bikerglen/pixpoe/README.md

# pixpoe
Control and power up to 20 W of neopixels or other WS2812b LEDs over ethernet!
