bikerglen/pixpoe/prints/2019-11-24/PixPoE-bottom-as-fabbed-2019-11-24.png

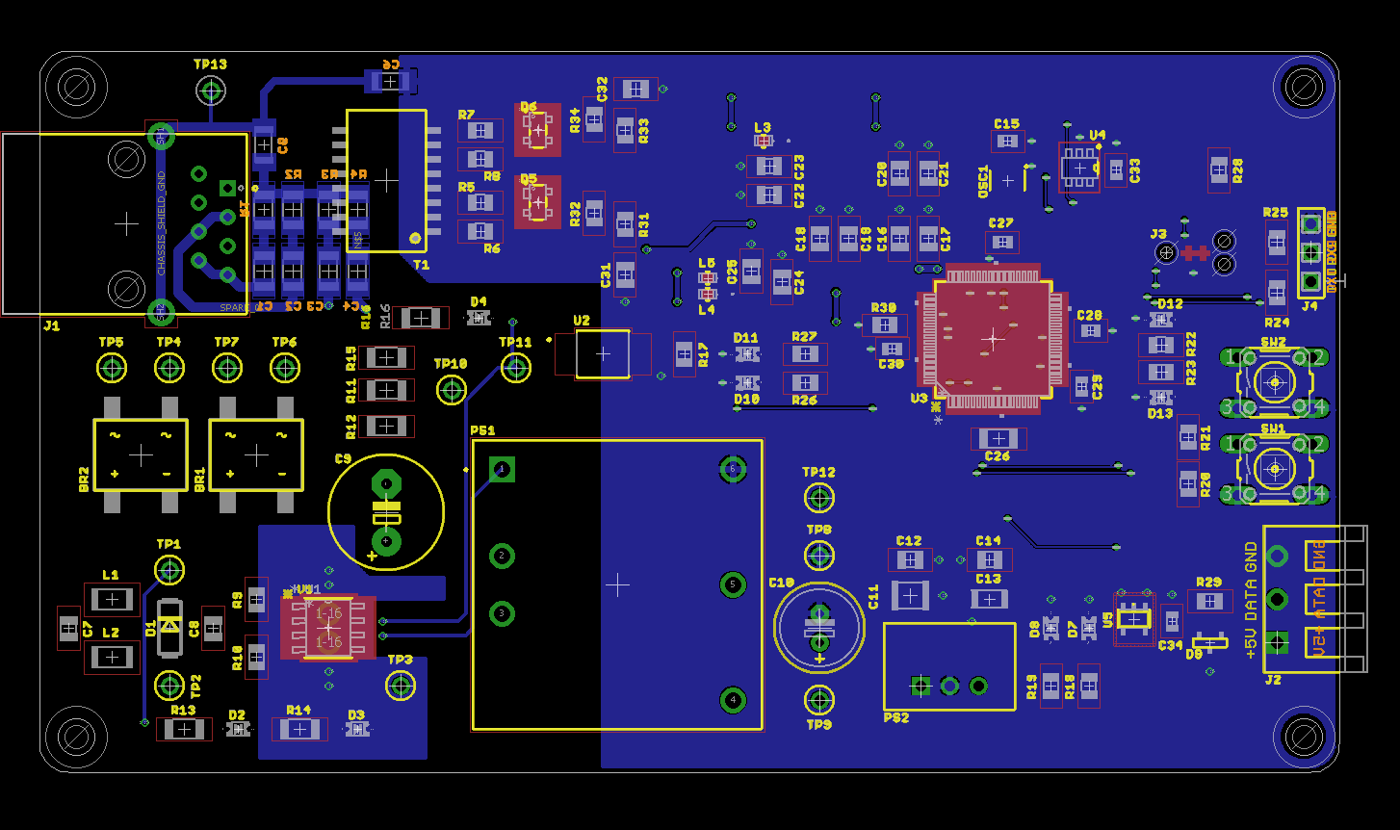
prints/2019-11-24/PixPoE-bottom-as-fabbed-2019-11-24.png
