bikerglen/pixpoe/(threads)

Thread 1 (2020-01-02):

BOM?

jayjlow, 2020-01-02:
Sorry if I missed it in your blog, but is there a handy BOM available?

bikerglen, 2020-01-02:
I'll upload it tonight after work. It's in the form of an Excel spreadsheet with Manufacturer and Digi-Key part numbers.

jayjlow, 2020-01-02:
Awe yeah. Thanks for responding so quickly. Have a great new years.

bikerglen, 2020-01-03:
BOM added to boards/v2 directory.

Closed 2020-01-02.
