bikerglen/pixpoe/prints/2019-11-24/PixPoE-schematic-as-fabbed-2019-11-24.pdf

# 7 R5

R18 | D7 R19 | D8 C6

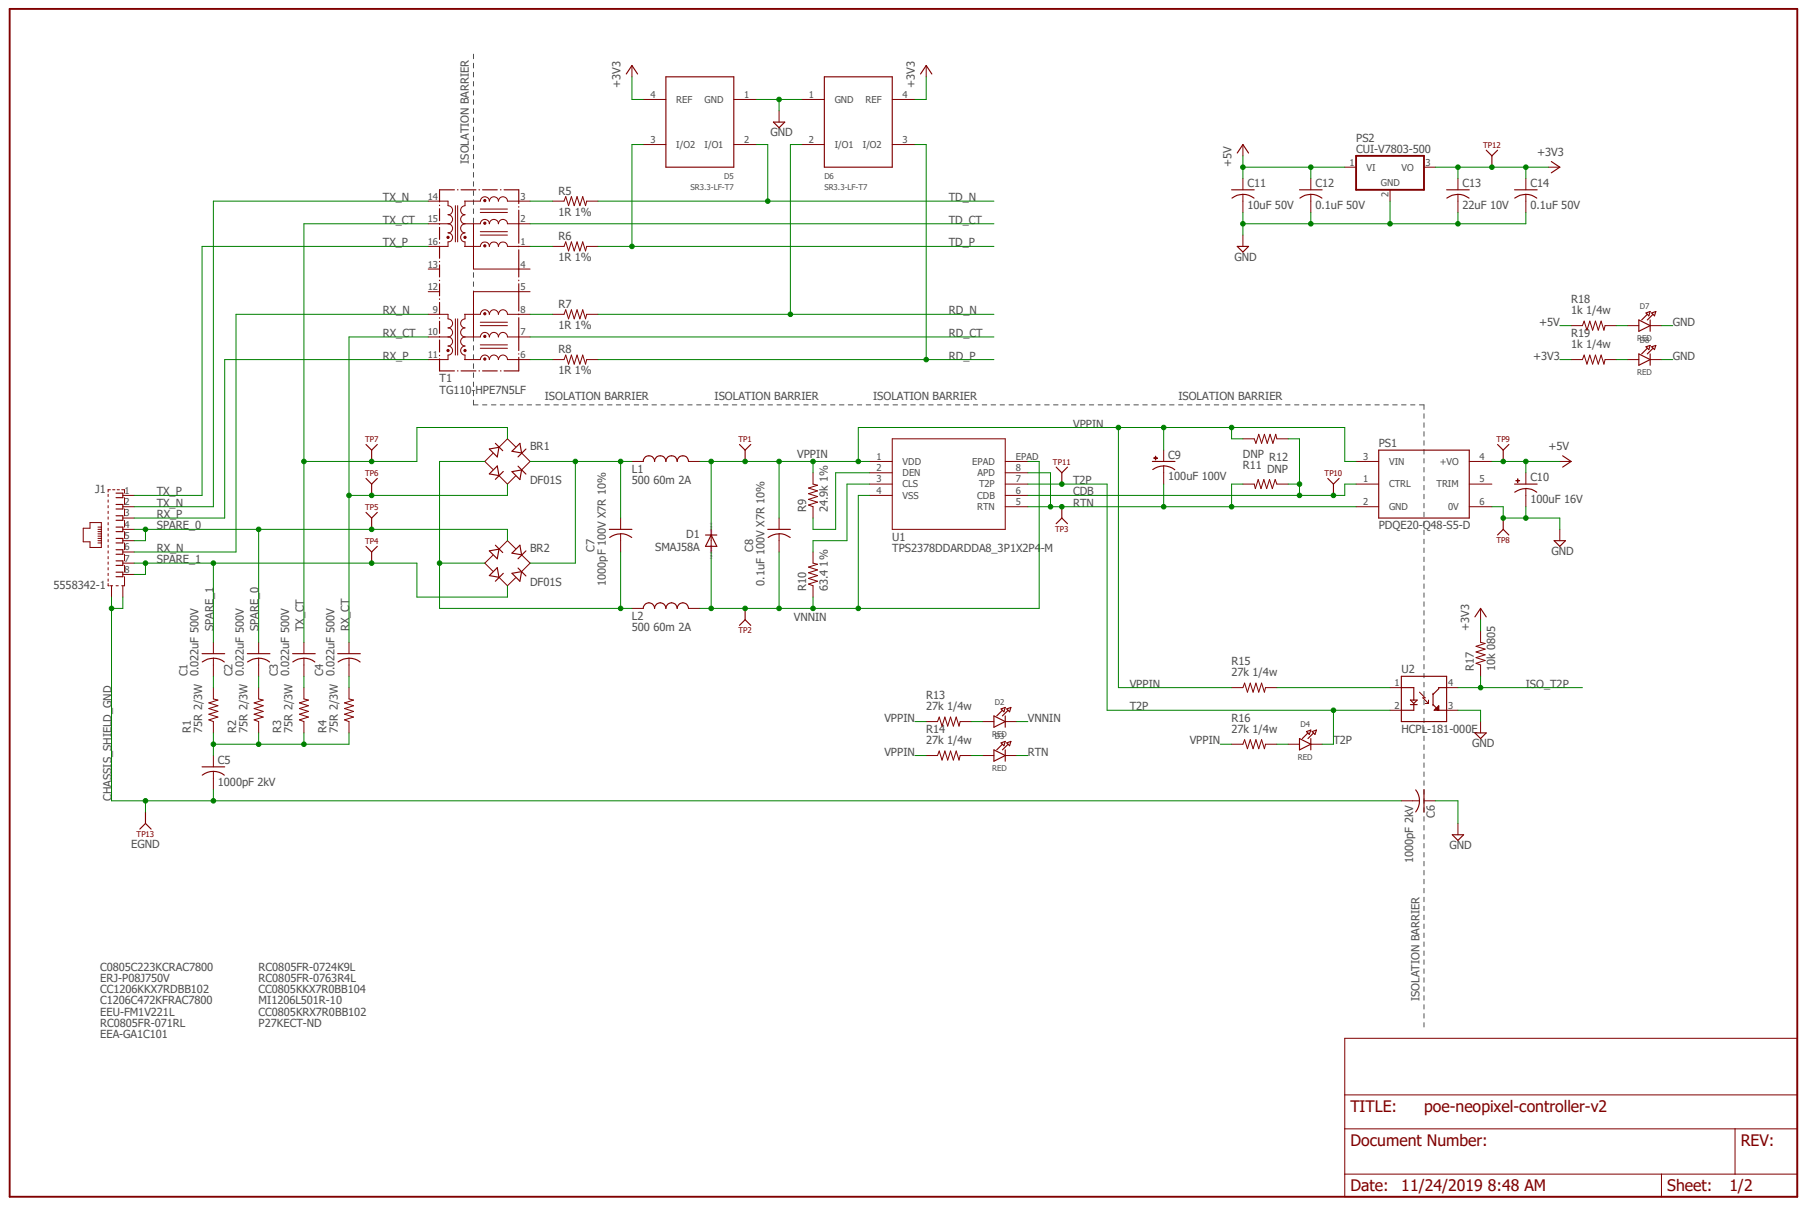
[picture p4: page 1]

Document Number: | REV:

Date: 11/24/2019 8:48 AM | Sheet: 1/2

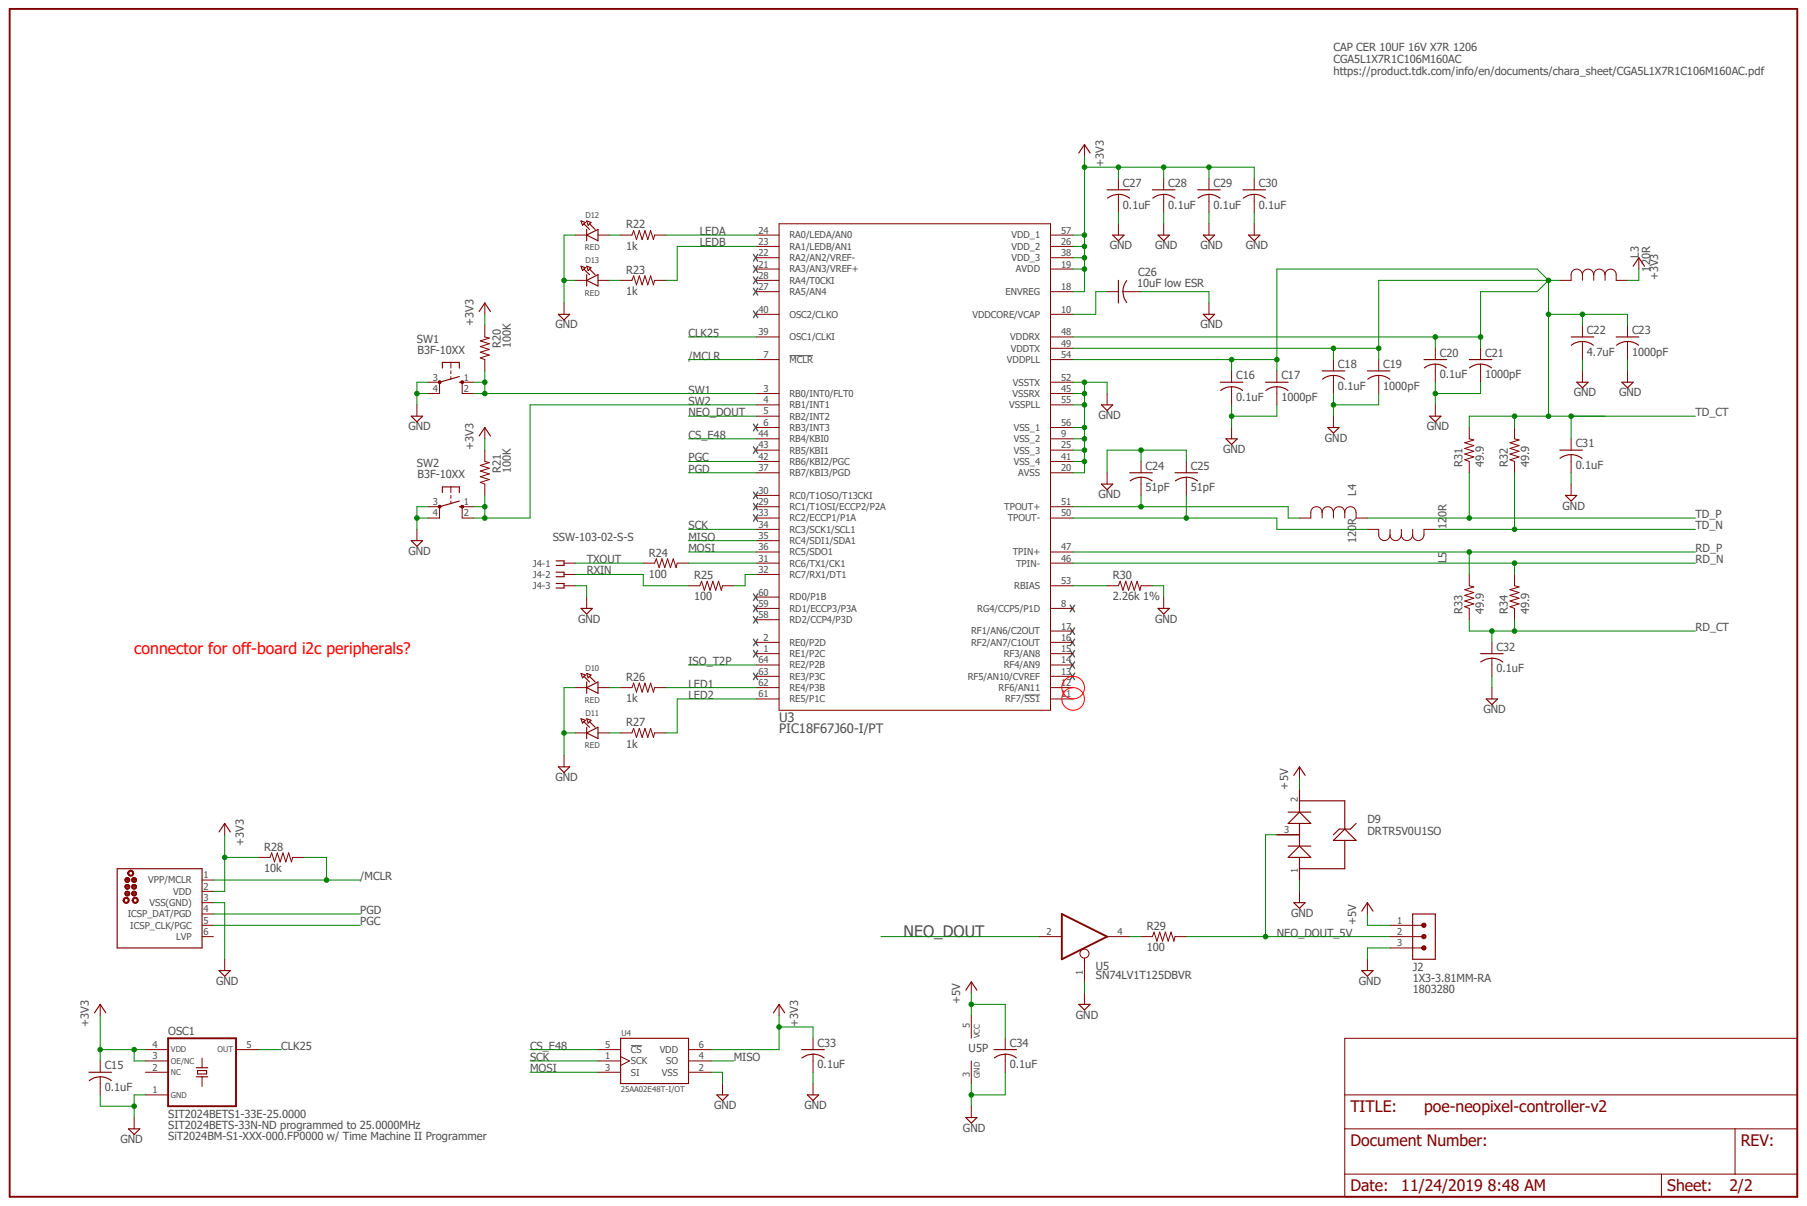
[picture p5: page 2]

CAP CER 10UF 16V X7R 1206
CGA5L1X7R1C106M160AC
https://product.tdk.com/info/en/documents/chara_sheet/CGA5L1X7R1C106M160AC.pdf

connector for off-board i2c peripherals?

SIT2024BETS1-33E-25.0000
SIT2024BETS-33N-ND programmed to 25.0000MHz
SiT2024BM-S1-XXX-000.FP0000 w/ Time Machine II Programmer

Document Number: | REV:

Date: 11/24/2019 8:48 AM | Sheet: 2/2
