bikerglen/pixpoe/boards/v2/poe-neopixel-controller-v2.brd

## EAGLE design boards/v2/poe-neopixel-controller-v2.brd (2019-11-24)

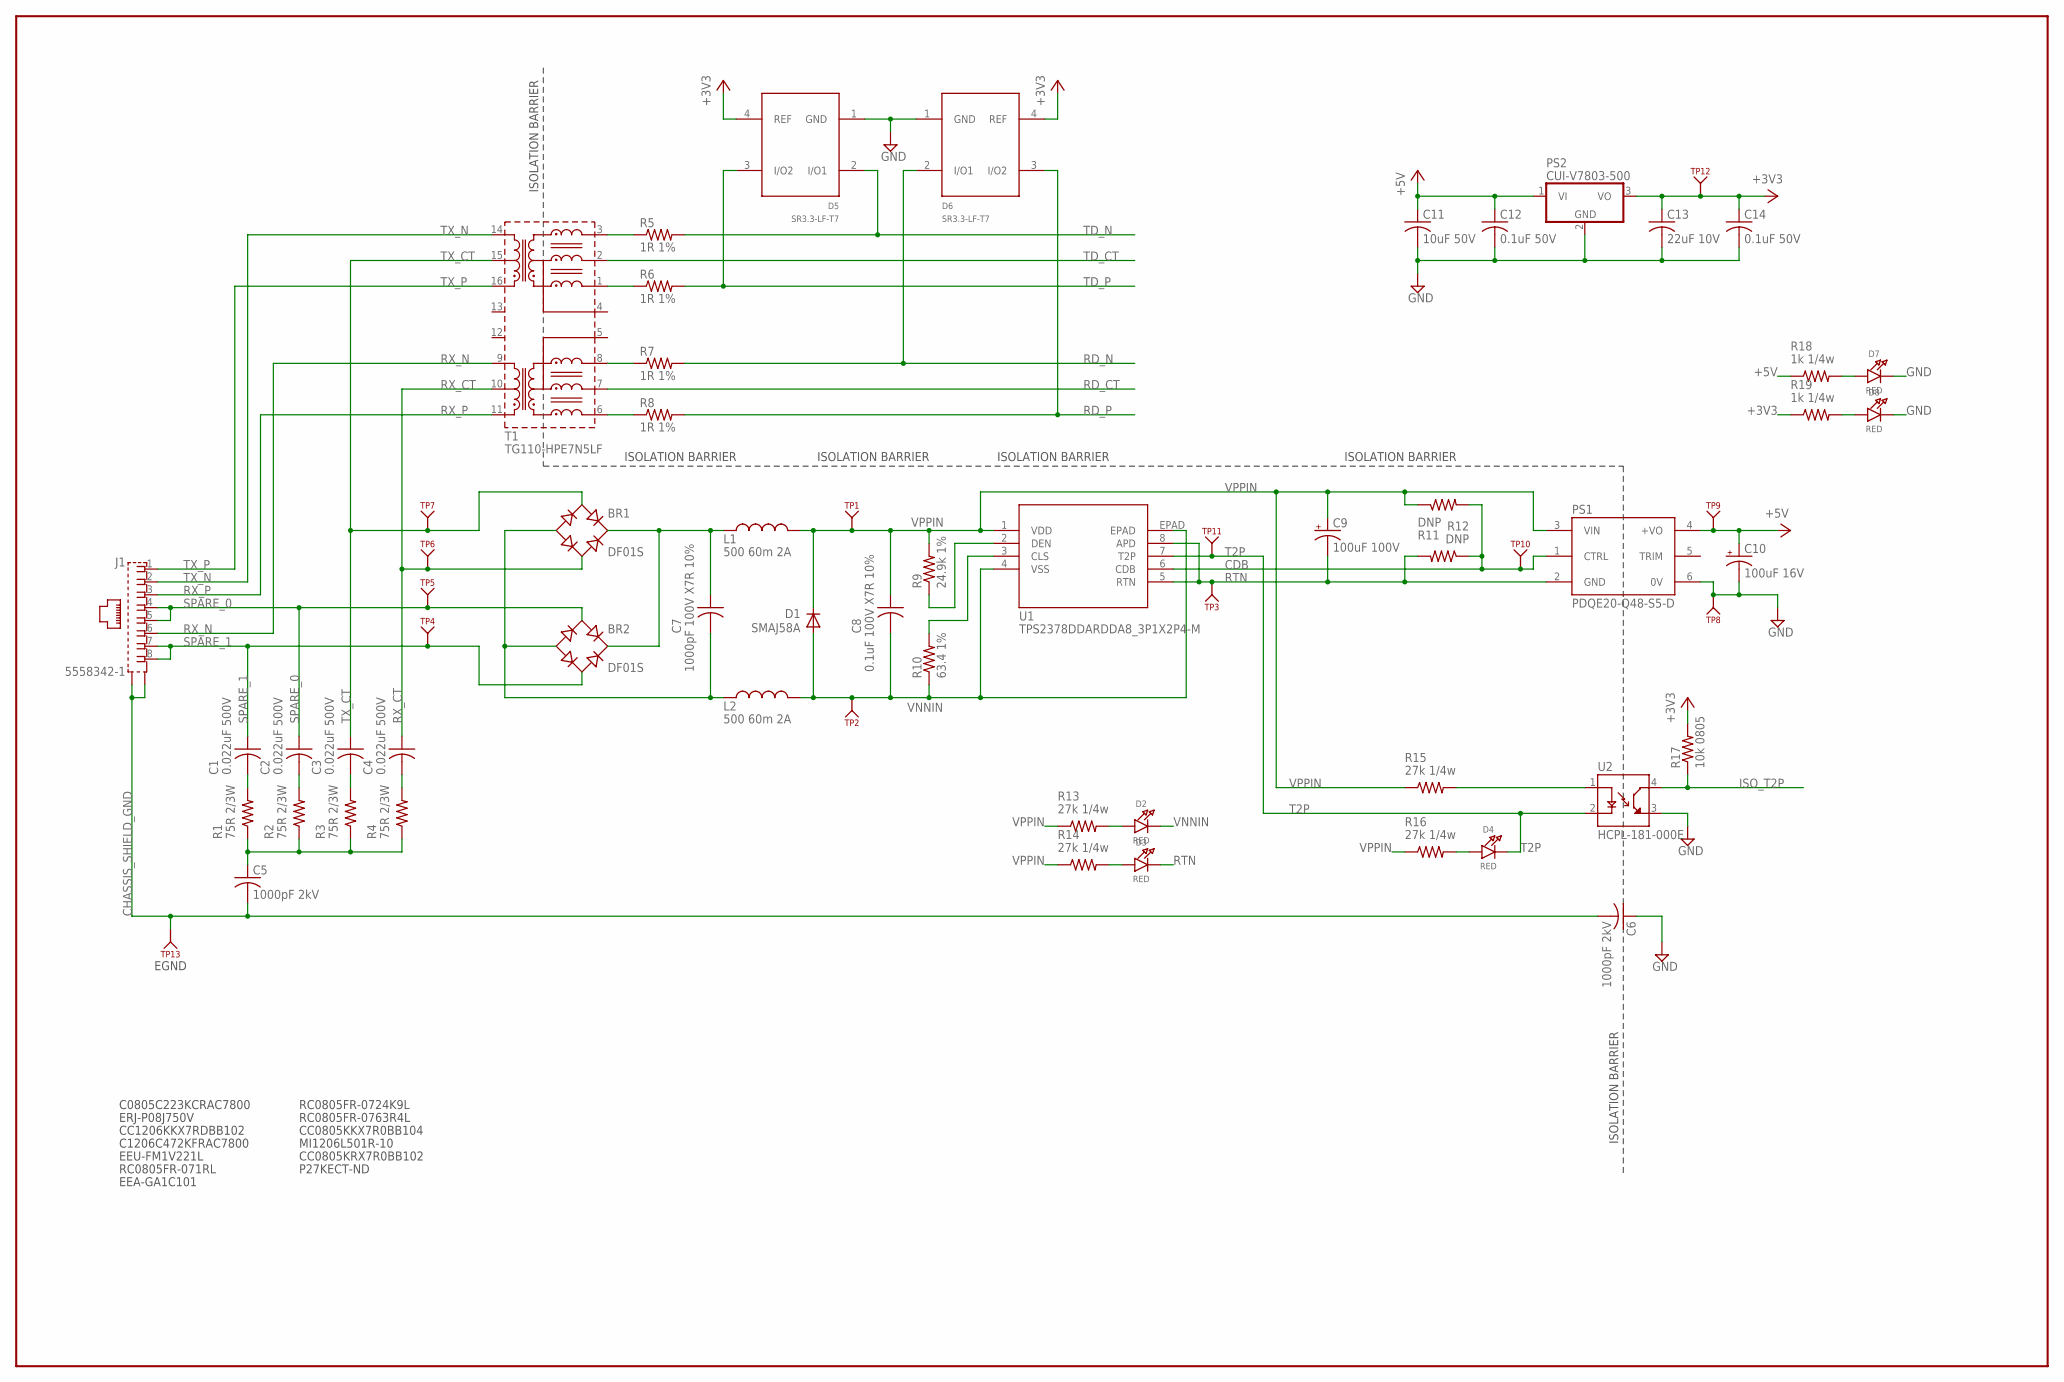
[picture p6: schematic poe-neopixel-controller-v2.sch, sheet 1]

Parts:
BR1, BR2: DF01S; DFS
C1, C2, C3, C4: 0.022uF 500V; C1206
C5, C6: 1000pF 2kV; C1206K
C7: 1000pF 100V X7R 10%; C0805
C8: 0.1uF 100V X7R 10%; C0805
C9: 100uF 100V; E5-10,5
C10: 100uF 16V; E2,5-7
C11: 10uF 50V; C1210K; MFR_PART_NO C1210C106K5RACTU
C12, C14: 0.1uF 50V; C0805; MFR_PART_NO C1206S104M5RACTU
C13: 22uF 10V; C1206K; MFR_PART_NO C1206C226K8RAC7800
D1: SMAJ58A; DO214AC
D2, D3, D4, D7, D8: RED; CHIPLED_0805_NOOUTLINE
D5, D6: SR3.3-LF-T7; SOT143B
J1: 5558342-1; TE_5558342-1
L1, L2: 500 60m 2A; L3216C
PS1: PDQE20-Q48-S5-D; CONV_PDQE20-Q48-S5-D
PS2: CUI-V7803-500; CUI-78XX-500
R1, R2, R3, R4: 75R 2/3W; R1206
R5, R6, R7, R8: 1R 1%; R0805
R9: 24.9k 1%; R0805
R10: 63.4 1%; R0805
R11, R12: DNP; R1206
R13, R14, R15, R16: 27k 1/4w; R1206
R17: 10k 0805; R0805
R18, R19: 1k 1/4w; R0805
T1: TG110-HPE7N5LF; RP-ULTRA
TP1, TP2, TP3, TP4, TP5, TP6, TP7, TP8, TP9, TP10, TP11, TP12, TP13: KEYSTONE_500X; KEYSTONE_TP500X
U1: TPS2378DDARDDA8_3P1X2P4-M; DDA8_3P1X2P4-M
U2: HCPL-181-000E; SOIC254P675X240-4N

Connections:
+3V3: C13.1, C14.1, D5.4 (REF), D6.4 (REF), PS2.3 (VO), R17.2, R19.1, TP12.1; also elsewhere on the board
+5V: C10.+, C11.1, C12.1, PS1.4 (+VO), PS2.1 (VI), R18.1, TP9.1; also elsewhere on the board
CDB: PS1.1 (CTRL), R11.2, R12.1, TP10.1, U1.6 (CDB)
CHASSIS_SHIELD_GND: C5.2, C6.2, J1.SH1 (S1), J1.SH2 (S2), TP13.1
GND: C6.1, C10.-, C11.2, C12.2, C13.2, C14.2, D5.1 (GND), D6.1 (GND), D7.C, D8.C, PS1.6 (0V), PS2.2 (GND), TP8.1, U2.3 (EMITTER); also elsewhere on the board
ISO_T2P: R17.1, U2.4 (COLLECTOR); also elsewhere on the board
unnamed: BR1.+, BR2.+, C7.1, L1.1
unnamed: R5.1, T1.3
unnamed: BR1.-, BR2.-, C7.2, L2.1
unnamed: R6.1, T1.1
unnamed: C4.2, R4.2
unnamed: R7.1, T1.8
unnamed: D2.A, R13.2
unnamed: R15.2, U2.1 (ANODE)
unnamed: R8.1, T1.6
unnamed: C1.2, R1.2
unnamed: C2.2, R2.2
unnamed: C3.2, R3.2
unnamed: C5.1, R1.1, R2.1, R3.1, R4.1
unnamed: R9.1, U1.2 (DEN)
unnamed: R10.2, U1.3 (CLS)
unnamed: D3.A, R14.2
unnamed: D4.A, R16.2
unnamed: D7.A, R18.2
unnamed: D8.A, R19.2
RD_CT: T1.7; also elsewhere on the board
RD_N: D6.2 (I/O1), R7.2; also elsewhere on the board
RD_P: D6.3 (I/O2), R8.2; also elsewhere on the board
RTN: C9.-, D3.C, PS1.2 (GND), R12.2, TP3.1, U1.5 (RTN), U1.8 (APD)
RX_CT: BR1.AC2, C4.1, T1.10, TP6.1
RX_N: J1.6, T1.9
RX_P: J1.3, T1.11
SPARE_0: BR2.AC1, C2.1, J1.4, J1.5, TP5.1
SPARE_1: BR2.AC2, C1.1, J1.7, J1.8, TP4.1
T2P: D4.C, TP11.1, U1.7 (T2P), U2.2 (CATHODE)
TD_CT: T1.2; also elsewhere on the board
TD_N: D5.2 (I/O1), R5.2; also elsewhere on the board
TD_P: D5.3 (I/O2), R6.2; also elsewhere on the board
TX_CT: BR1.AC1, C3.1, T1.15, TP7.1
TX_N: J1.2, T1.14
TX_P: J1.1, T1.16
VNNIN: C8.2, D1.A, D2.C, L2.2, R10.1, TP2.1, U1.4 (VSS), U1.EPAD
VPPIN: C8.1, C9.+, D1.C, L1.2, PS1.3 (VIN), R9.2, R11.1, R13.1, R14.1, R15.1, R16.1, TP1.1, U1.1 (VDD)

Notes on the sheet:
C0805C223KCRAC7800
ERJ-P08J750V
CC1206KKX7RDBB102
C1206C472KFRAC7800
EEU-FM1V221L
ISOLATION BARRIER
RC0805FR-071RL
EEA-GA1C101
RC0805FR-0724K9L
RC0805FR-0763R4L
CC0805KKX7R0BB104
MI1206L501R-10
CC0805KRX7R0BB102
P27KECT-ND
EGND

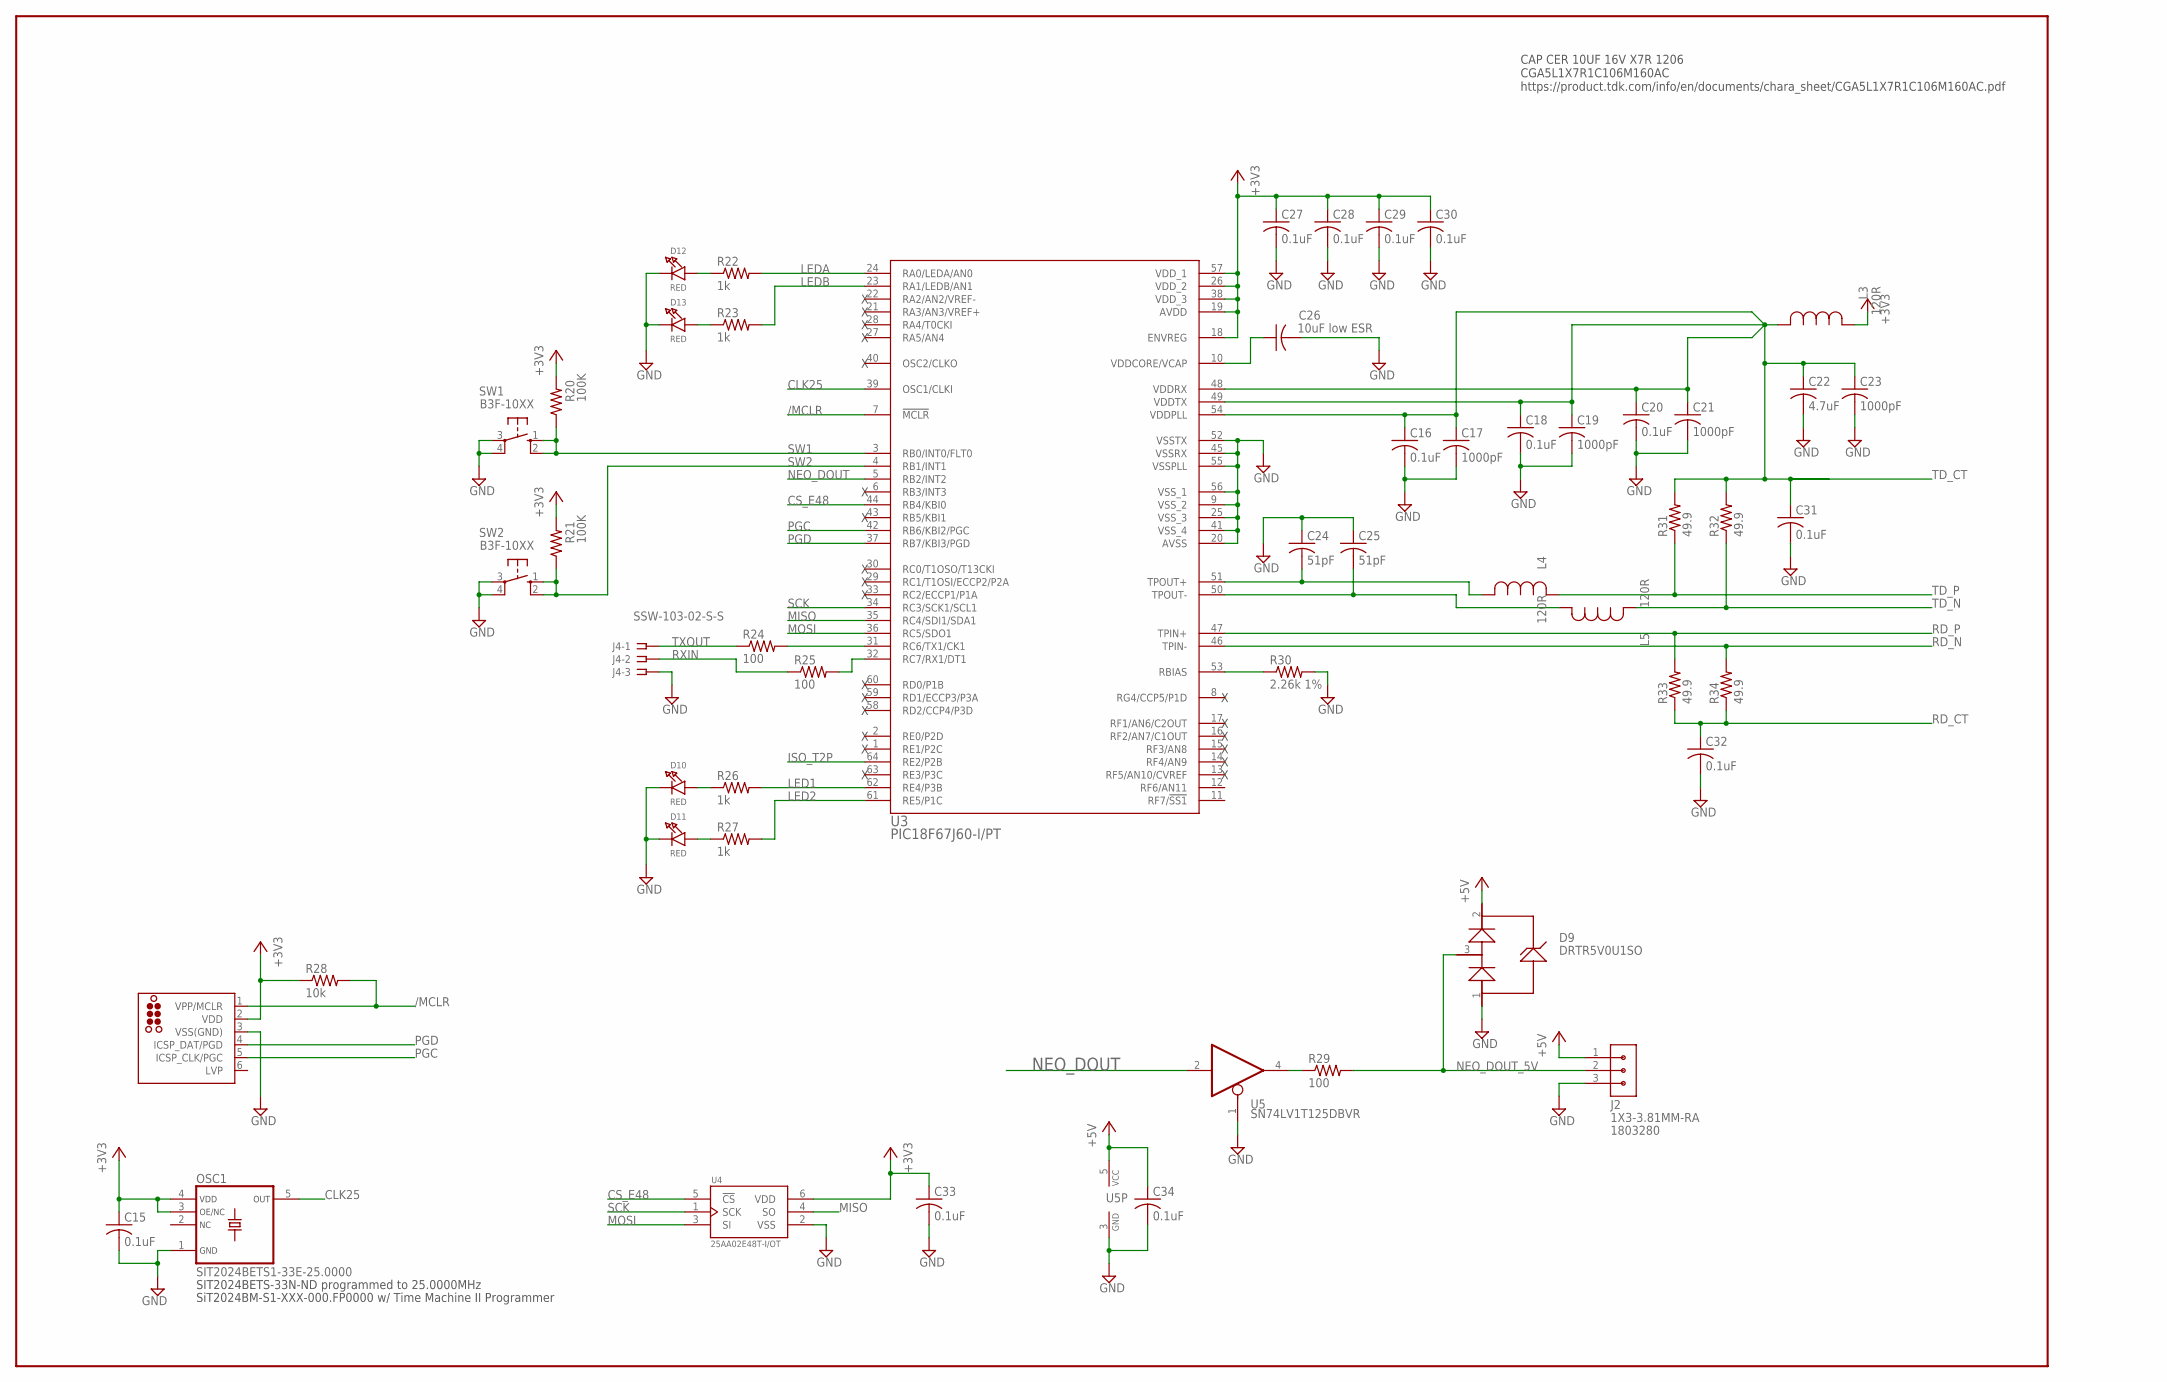
[picture p7: schematic poe-neopixel-controller-v2.sch, sheet 2]

Parts:
C15, C27, C28, C29, C30, C33, C34: 0.1uF; C0603
C16, C18, C20, C31, C32: 0.1uF; C0805
C17, C19, C21, C23: 1000pF; C0805
C22: 4.7uF; C0805
C24, C25: 51pF; C0805
C26: 10uF low ESR; C1206
D9: DRTR5V0U1SO; SOT23-3; MFR_PART_NO DRTR5V0U1SO
D10, D11, D12, D13: RED; CHIPLED_0805_NOOUTLINE
J2: 1X3-3.81MM-RA; CON-PHOENIX-3.81-1X3-RA; MFR_PART_NO 1803280
J3: TC2030-MCP-NL
J4: SSW-103-02-S-S
L3, L4, L5: 120R; IND_1608-M
OSC1: SIT2024BETS1-33E-25.0000; SOT23-5
R20, R21: 100K; R0805
R22, R23, R26, R27: 1k; R0805
R24, R25, R29: 100; R0805
R28: 10k; R0805
R30: 2.26k 1%; R0805
R31, R32, R33, R34: 49.9; R0805
SW1, SW2: B3F-10XX
U3: PIC18F67J60-I/PT; TQFP64_10X10MC
U4: 25AA02E48T-I/OT; SOT95P270X145-6N
U5: SN74LV1T125DBVR; SOT23-5; MFR_PART_NO SN74LV1T125DBVR

Connections:
+3V3: C15.1, C27.1, C28.1, C29.1, C30.1, C33.1, J3.2 (VDD), L3.2, OSC1.3 (OE/NC), OSC1.4 (VDD), R20.2, R21.2, R28.1, U3.18 (ENVREG), U3.19 (AVDD), U3.26 (VDD_2), U3.38 (VDD_3), U3.57 (VDD_1), U4.6 (VDD); also elsewhere on the board
+5V: C34.1, D9.2, J2.1, U5.5 (VCC); also elsewhere on the board
/MCLR: J3.1 (VPP/MCLR), R28.2, U3.7 (!MCLR)
CLK25: OSC1.5 (OUT), U3.39 (OSC1/CLKI)
CS_E48: U3.44 (RB4/KBI0), U4.5 (!CS)
DATA_5V: R29.1, U5.4 (O)
GND: C15.2, C16.2, C17.2, C18.2, C19.2, C20.2, C21.2, C22.2, C23.2, C24.1, C25.1, C26.2, C27.2, C28.2, C29.2, C30.2, C31.2, C32.2, C33.2, C34.2, D9.1 (3), D10.C, D11.C, D12.C, D13.C, J2.3, J3.3 (VSS(GND)), J4.3, OSC1.1 (GND), R30.2, SW1.3, SW1.4 (P1), SW2.3, SW2.4 (P1), U3.9 (VSS_2), U3.20 (AVSS), U3.25 (VSS_3), U3.41 (VSS_4), U3.45 (VSSRX), U3.52 (VSSTX), U3.55 (VSSPLL), U3.56 (VSS_1), U4.2 (VSS), U5.1 (OE), U5.3 (GND); also elsewhere on the board
ISO_T2P: U3.64 (RE2/P2B); also elsewhere on the board
LED1: R26.2, U3.62 (RE4/P3B)
LED2: R27.2, U3.61 (RE5/P1C)
LEDA: R22.2, U3.24 (RA0/LEDA/AN0)
LEDB: R23.2, U3.23 (RA1/LEDB/AN1)
MISO: U3.35 (RC4/SDI1/SDA1), U4.4 (SO)
MOSI: U3.36 (RC5/SDO1), U4.3 (SI)
unnamed: C26.1, U3.10 (VDDCORE/VCAP)
unnamed: R30.1, U3.53 (RBIAS)
unnamed: D13.A, R23.1
unnamed: D10.A, R26.1
unnamed: D11.A, R27.1
unnamed: D12.A, R22.1
NEO_DOUT: U3.5 (RB2/INT2), U5.2 (I)
NEO_DOUT_5V: D9.3 (1), J2.2, R29.2
PGC: J3.5 (ICSP_CLK/PGC), U3.42 (RB6/KBI2/PGC)
PGD: J3.4 (ICSP_DAT/PGD), U3.37 (RB7/KBI3/PGD)
RD_CT: C32.1, R33.1, R34.1; also elsewhere on the board
RD_N: R34.2, U3.46 (TPIN-); also elsewhere on the board
RD_P: R33.2, U3.47 (TPIN+); also elsewhere on the board
RXD: R25.2, U3.32 (RC7/RX1/DT1)
RXIN: J4.2, R25.1
SCK: U3.34 (RC3/SCK1/SCL1), U4.1 (SCK)
SW1: R20.1, SW1.1 (S), SW1.2 (S1), U3.3 (RB0/INT0/FLT0)
SW2: R21.1, SW2.1 (S), SW2.2 (S1), U3.4 (RB1/INT1)
TDF_N: C25.2, L5.1, U3.50 (TPOUT-)
TDF_P: C24.2, L4.1, U3.51 (TPOUT+)
TD_CT: C16.1, C17.1, C18.1, C19.1, C20.1, C21.1, C22.1, C23.1, C31.1, L3.1, R31.2, R32.2, U3.48 (VDDRX), U3.49 (VDDTX), U3.54 (VDDPLL); also elsewhere on the board
TD_N: L5.2, R32.1; also elsewhere on the board
TD_P: L4.2, R31.1; also elsewhere on the board
TXD: R24.2, U3.31 (RC6/TX1/CK1)
TXOUT: J4.1, R24.1

Notes on the sheet:
SIT2024BETS-33N-ND programmed to 25.0000MHz
SiT2024BM-S1-XXX-000.FP0000 w/ Time Machine II Programmer
CAP CER 10UF 16V X7R 1206 CGA5L1X7R1C106M160AC https://product.tdk.com/info/en/documents/chara_sheet/CGA5L1X7R1C106M160AC.pdf

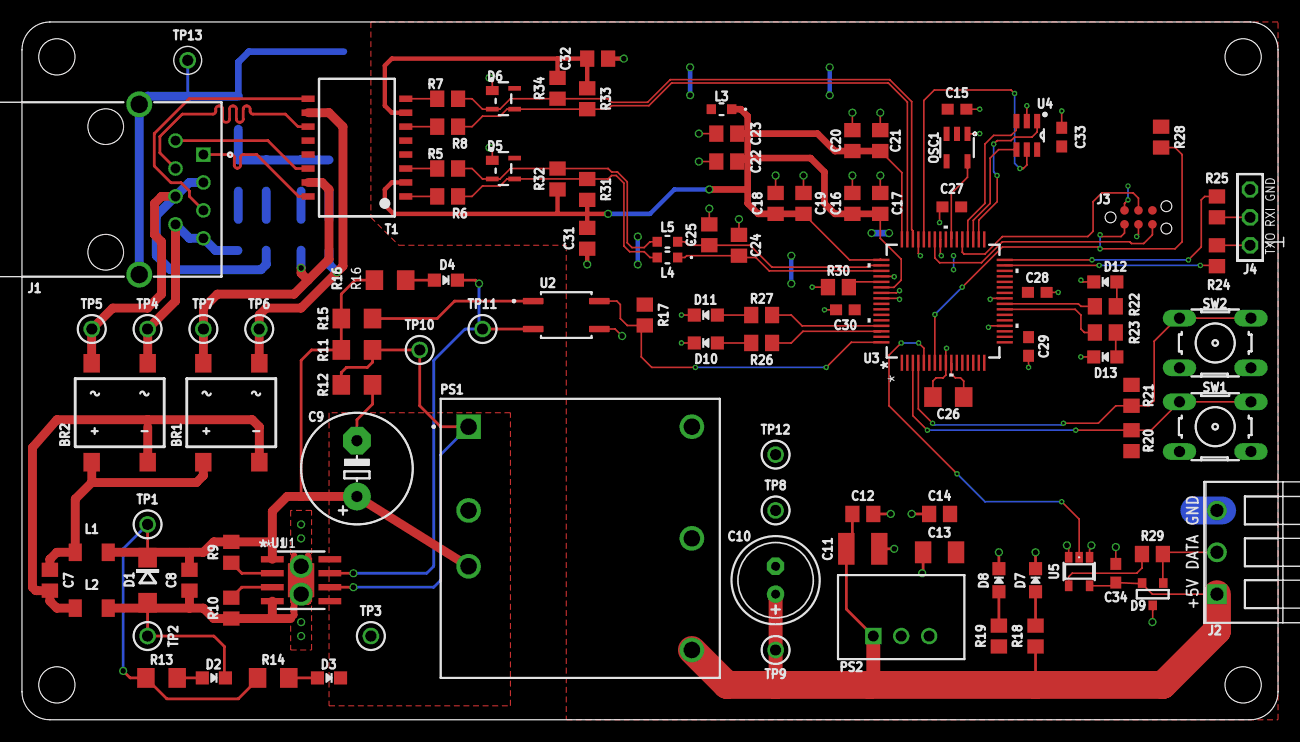
[picture p8: board poe-neopixel-controller-v2.brd from above]

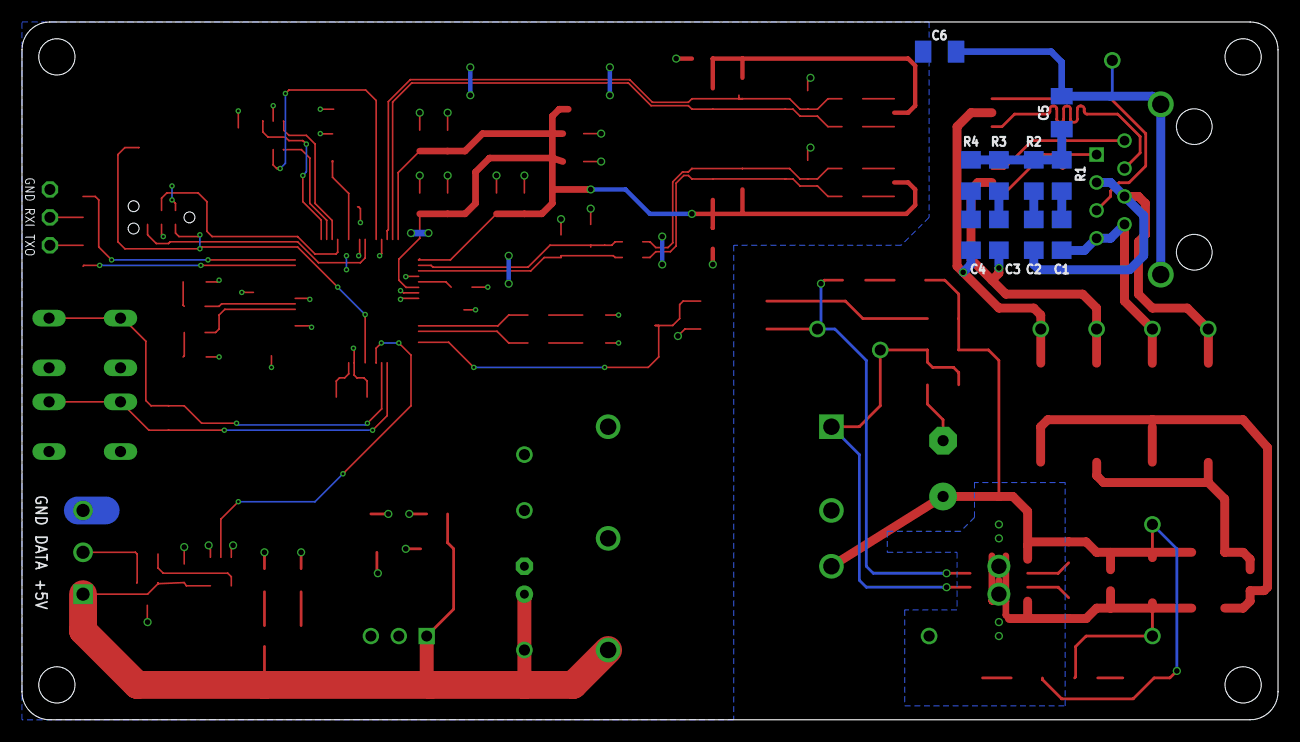
[picture p9: board poe-neopixel-controller-v2.brd from below]

Board: 2 copper layers, 114.3 x 63.5 mm, 116 parts (10 on the bottom side), 72 nets.
