bikerglen/pixpoe/(commit log)

2019-11-24 initial checkin
    [poe-neopixel-controller-v2.brd, poe-neopixel-controller-v2.sch]
2020-01-02 checkin bom
    [poe-neopixel-controller-v2-bom.xlsx]
